zhaoxiaodong95/Lucifer/Random Photos Taken/Picture.png

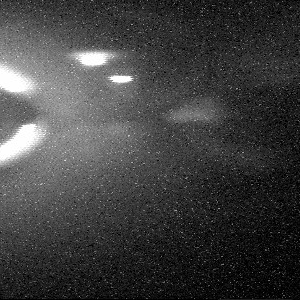
Random Photos Taken/Picture.png
