zhaoxiaodong95/Lucifer/Random Photos Taken/woot.png

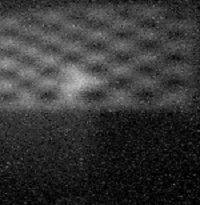
Random Photos Taken/woot.png
