zhaoxiaodong95/Lucifer/Source/Readme.md

Original source code written in Processing for Arduino
