zhaoxiaodong95/Lucifer/Marketing Brochure/Glow/Brochure Back Glow.jpg

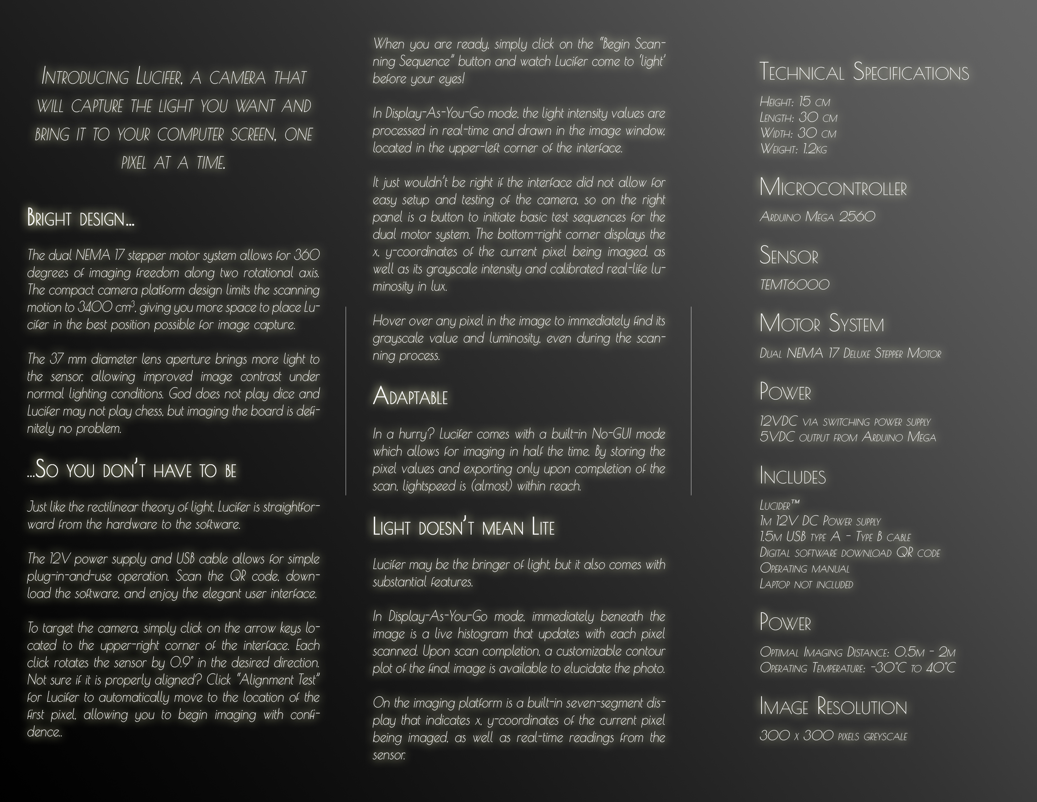
Marketing Brochure/Glow/Brochure Back Glow.jpg
