zhaoxiaodong95/Lucifer/Marketing Brochure/Glow/Brochure Front Glow.jpg

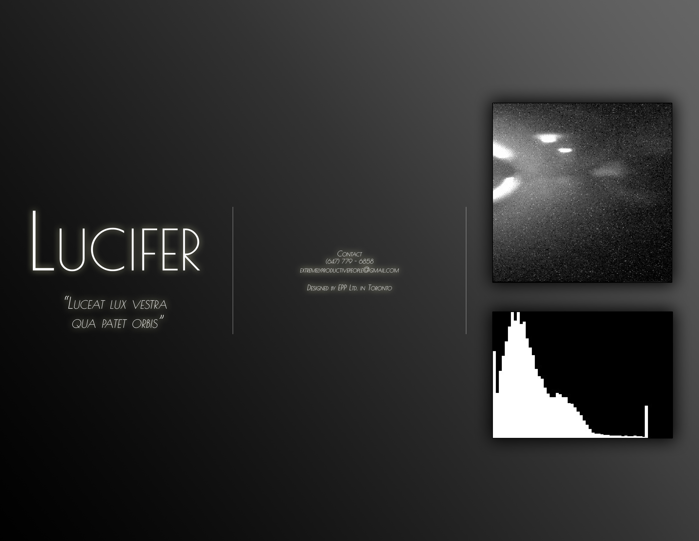
Marketing Brochure/Glow/Brochure Front Glow.jpg
