zhaoxiaodong95/Lucifer/Marketing Brochure/No-Glow/Brochure Back NoGlow.jpg

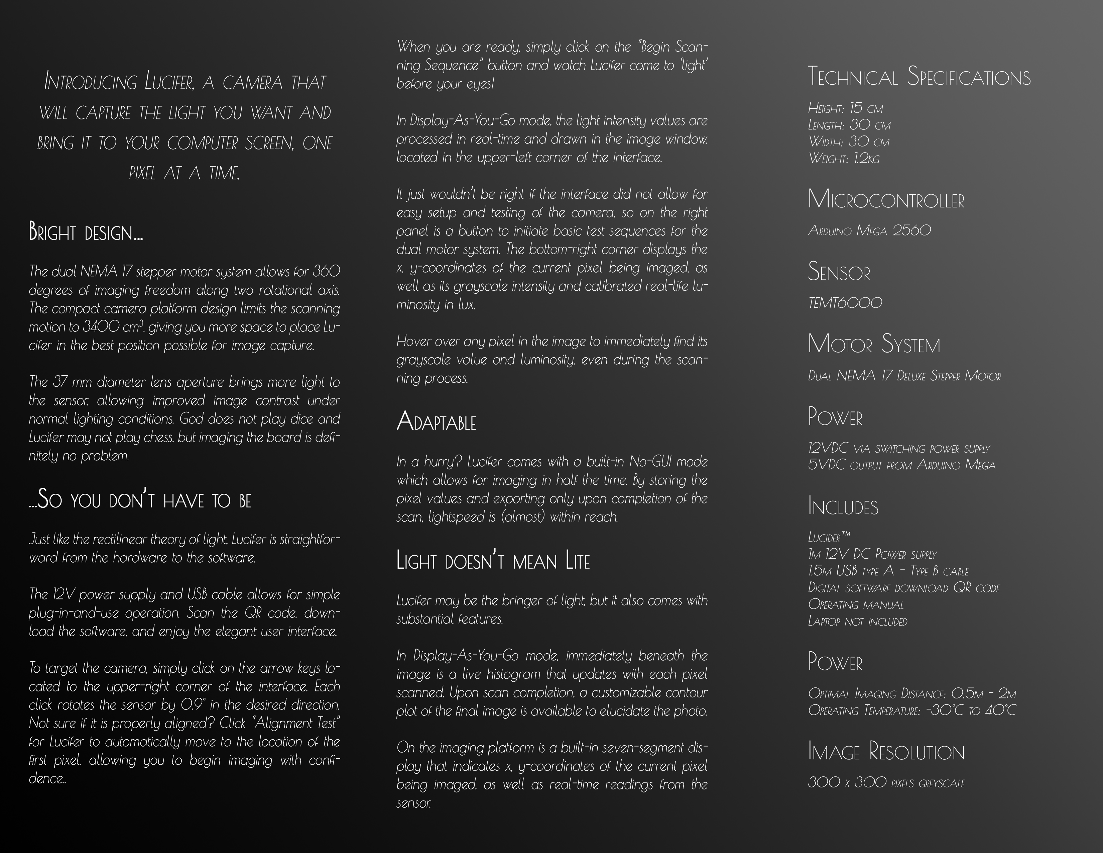
Marketing Brochure/No-Glow/Brochure Back NoGlow.jpg
