zhaoxiaodong95/Lucifer/Random Photos Taken/40x40.PNG

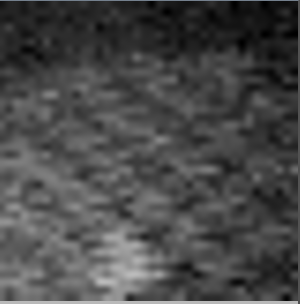
Random Photos Taken/40x40.PNG
