zhaoxiaodong95/Lucifer/Random Photos Taken/chessboard.PNG

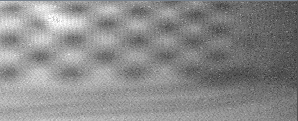
Random Photos Taken/chessboard.PNG
