zhaoxiaodong95/Lucifer/Random Photos Taken/noice we're done.PNG

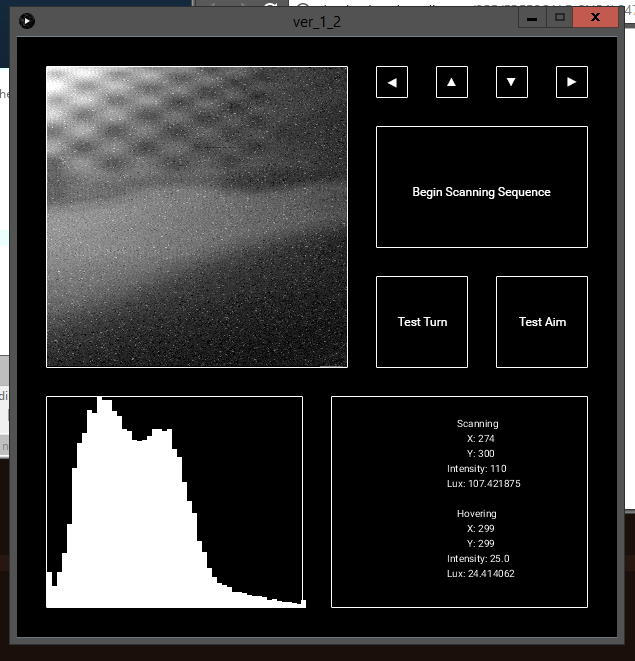
Random Photos Taken/noice we're done.PNG
