zhaoxiaodong95/Lucifer/Random Photos Taken/we done bois.jpg

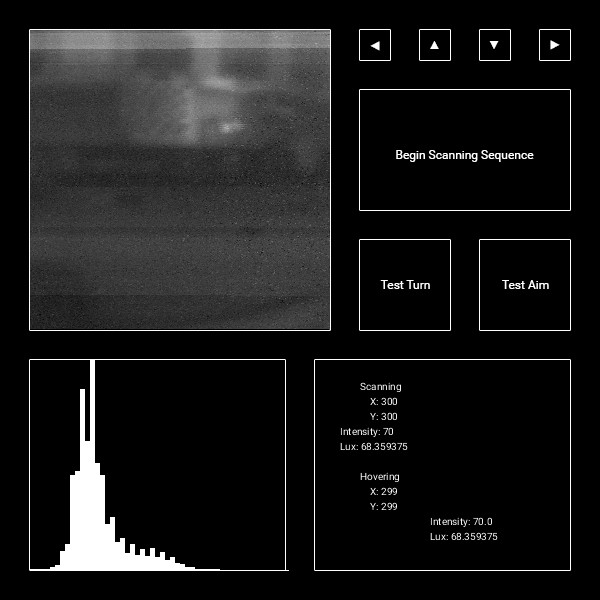
Random Photos Taken/we done bois.jpg
