zhaoxiaodong95/Lucifer/Source/bg.jpg

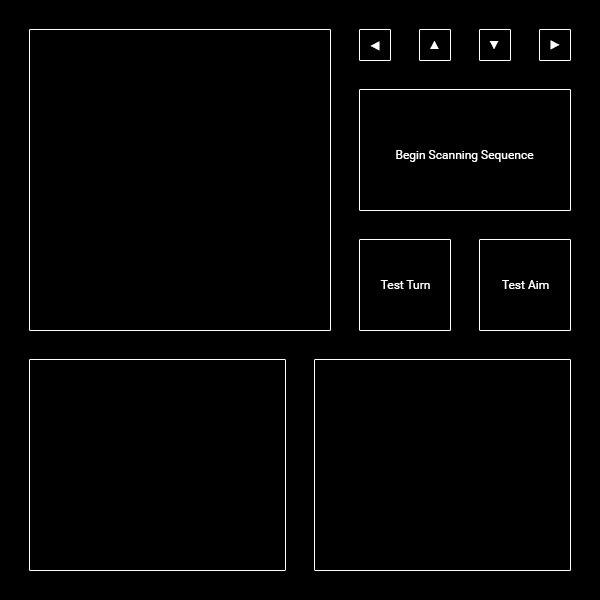
Source/bg.jpg
