zhaoxiaodong95/Lucifer/Design Blueprints/Base.pdf

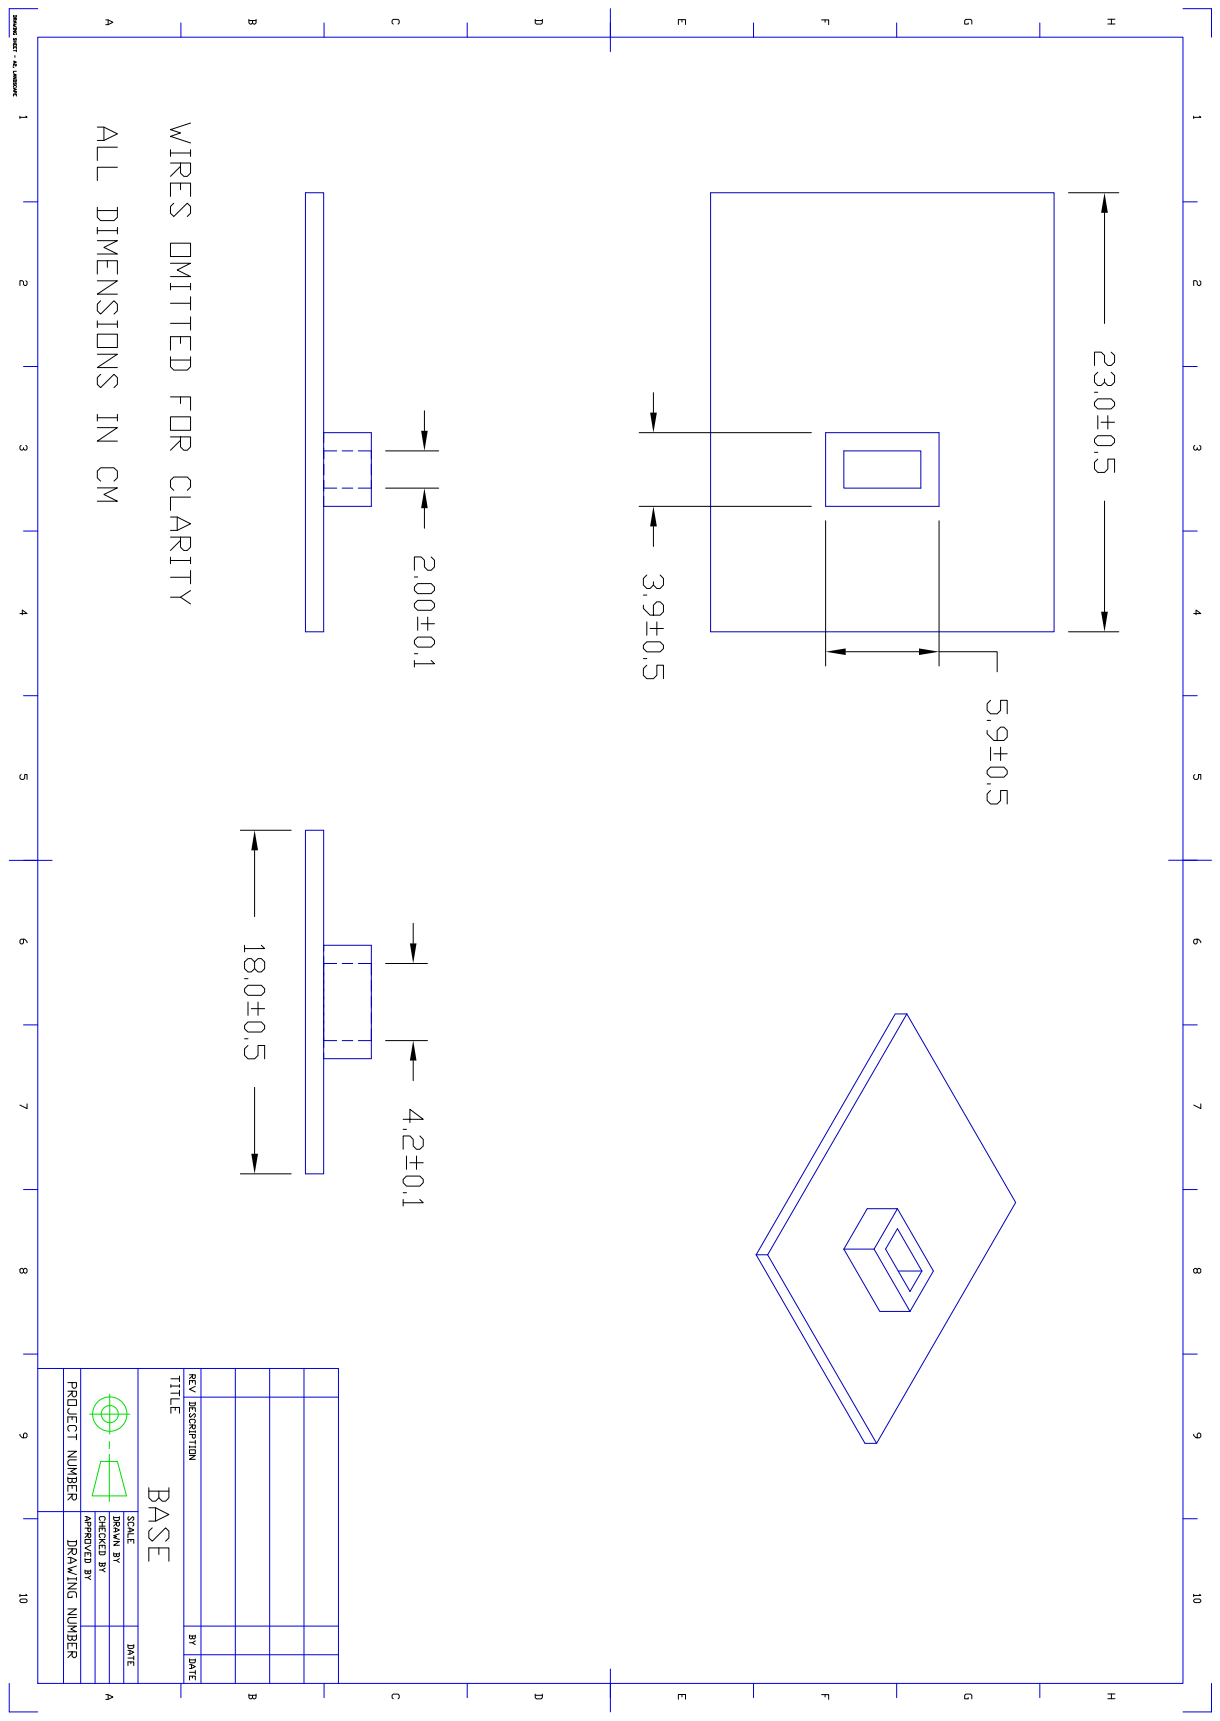
[picture p22: page 1]
