zhaoxiaodong95/Lucifer/Design Blueprints/Camera Assembly.pdf

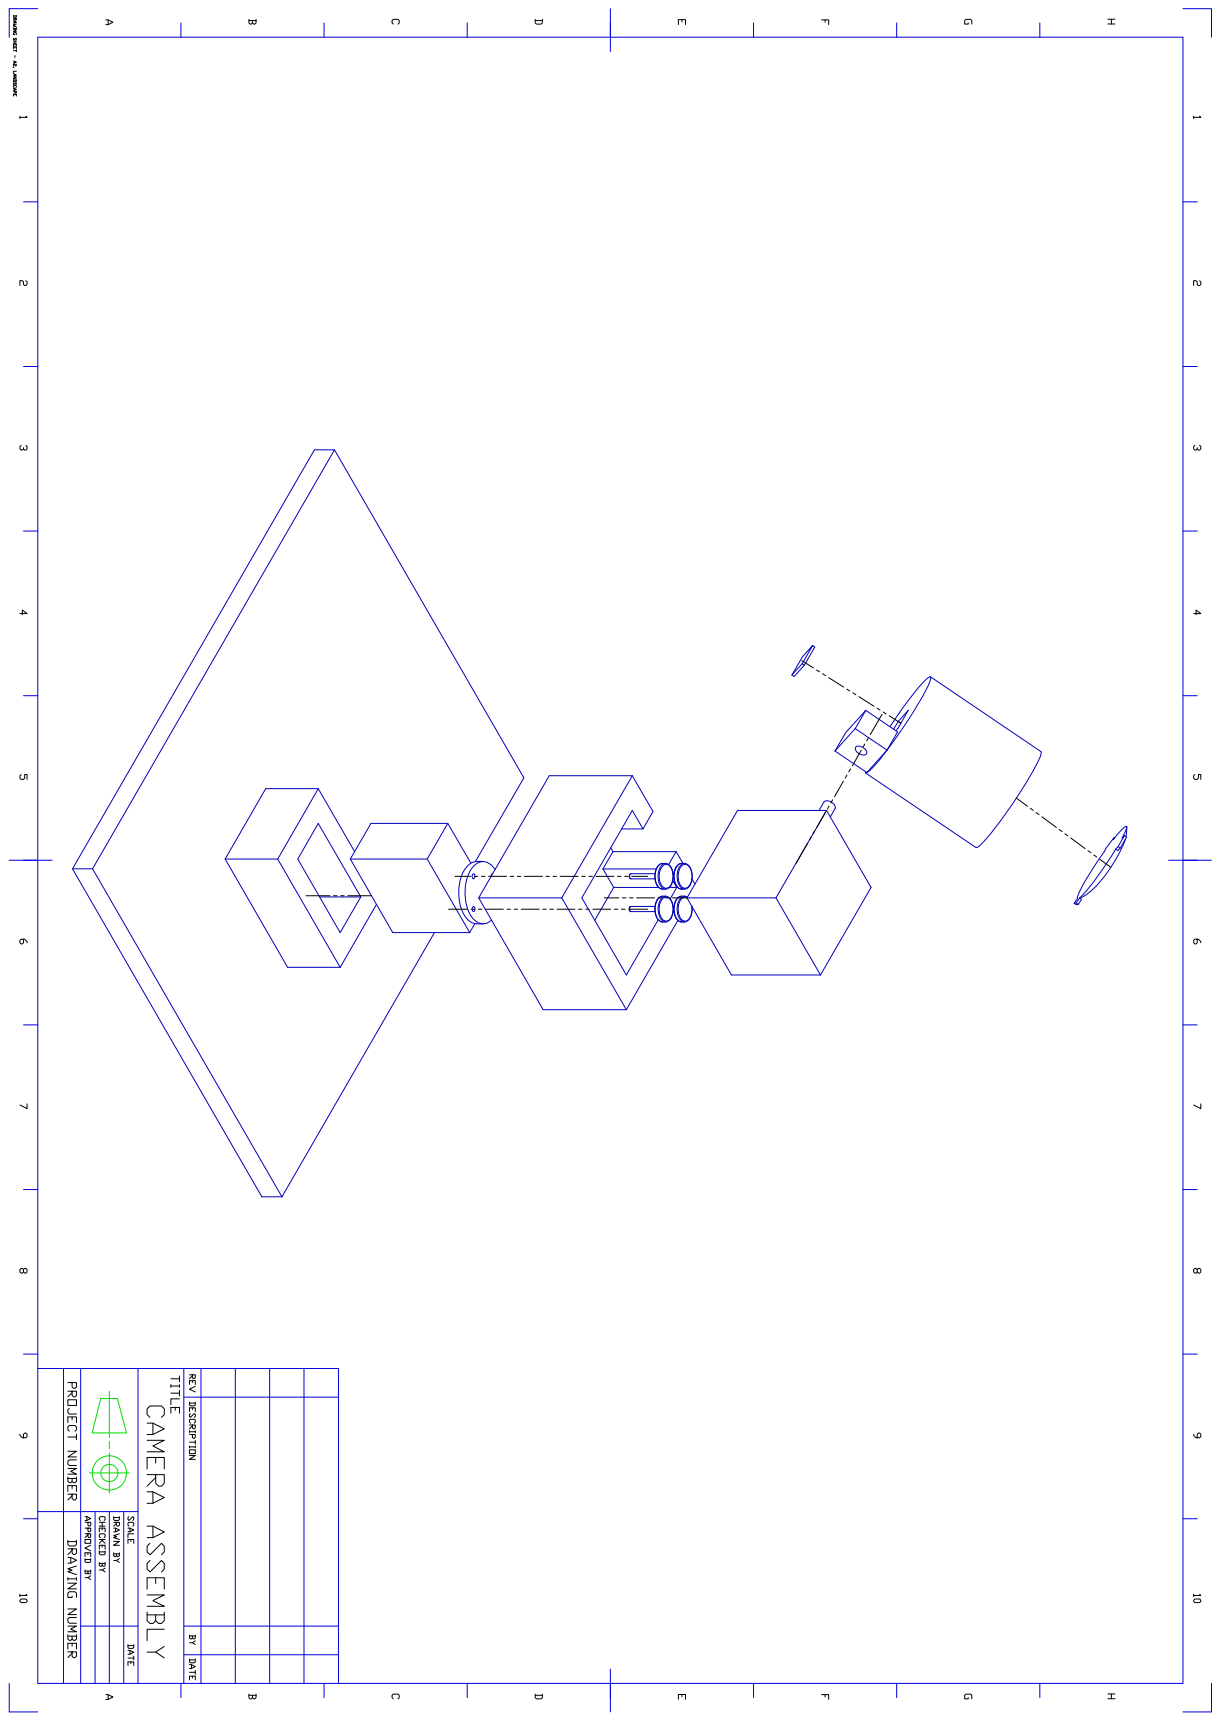
[picture p23: page 1]
