zhaoxiaodong95/Lucifer/Design Blueprints/Imaging Assembly.pdf

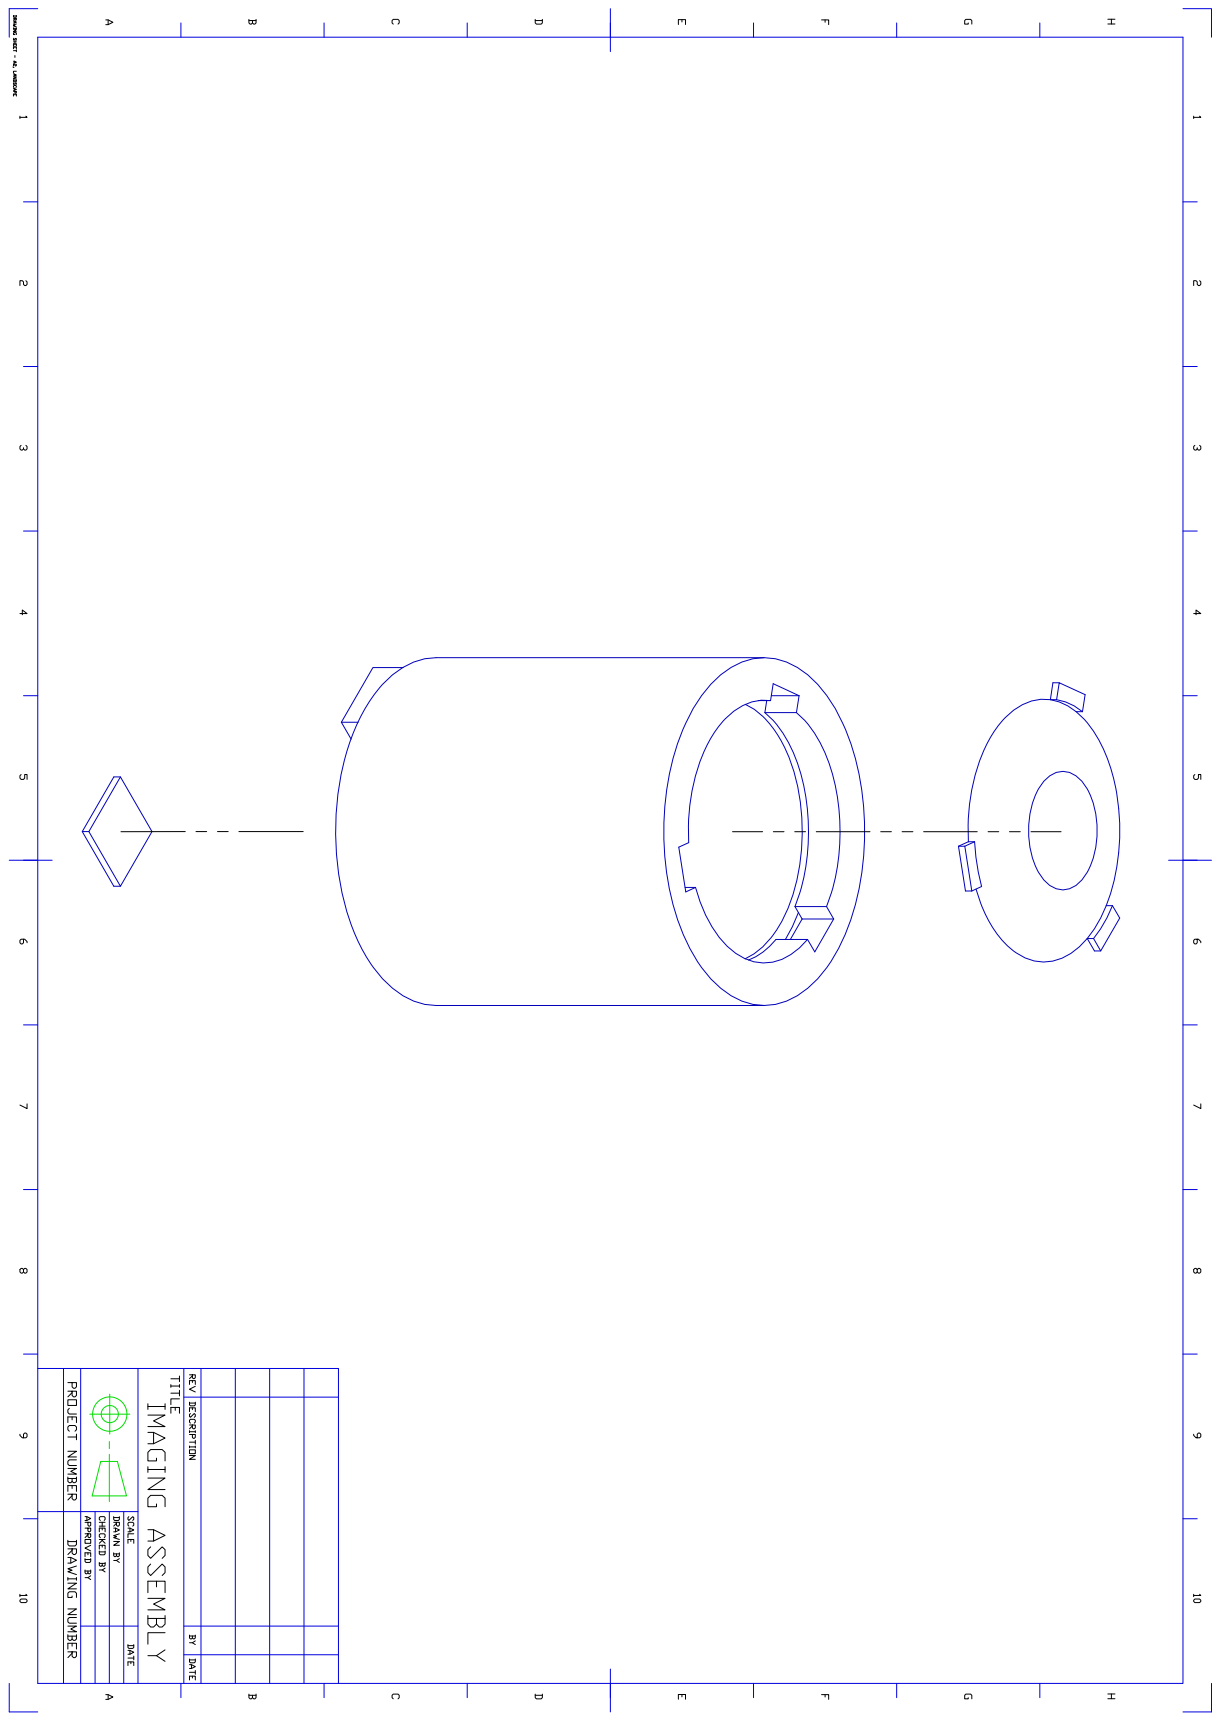
[picture p24: page 1]
