zhaoxiaodong95/Lucifer/Design Blueprints/Lens.pdf

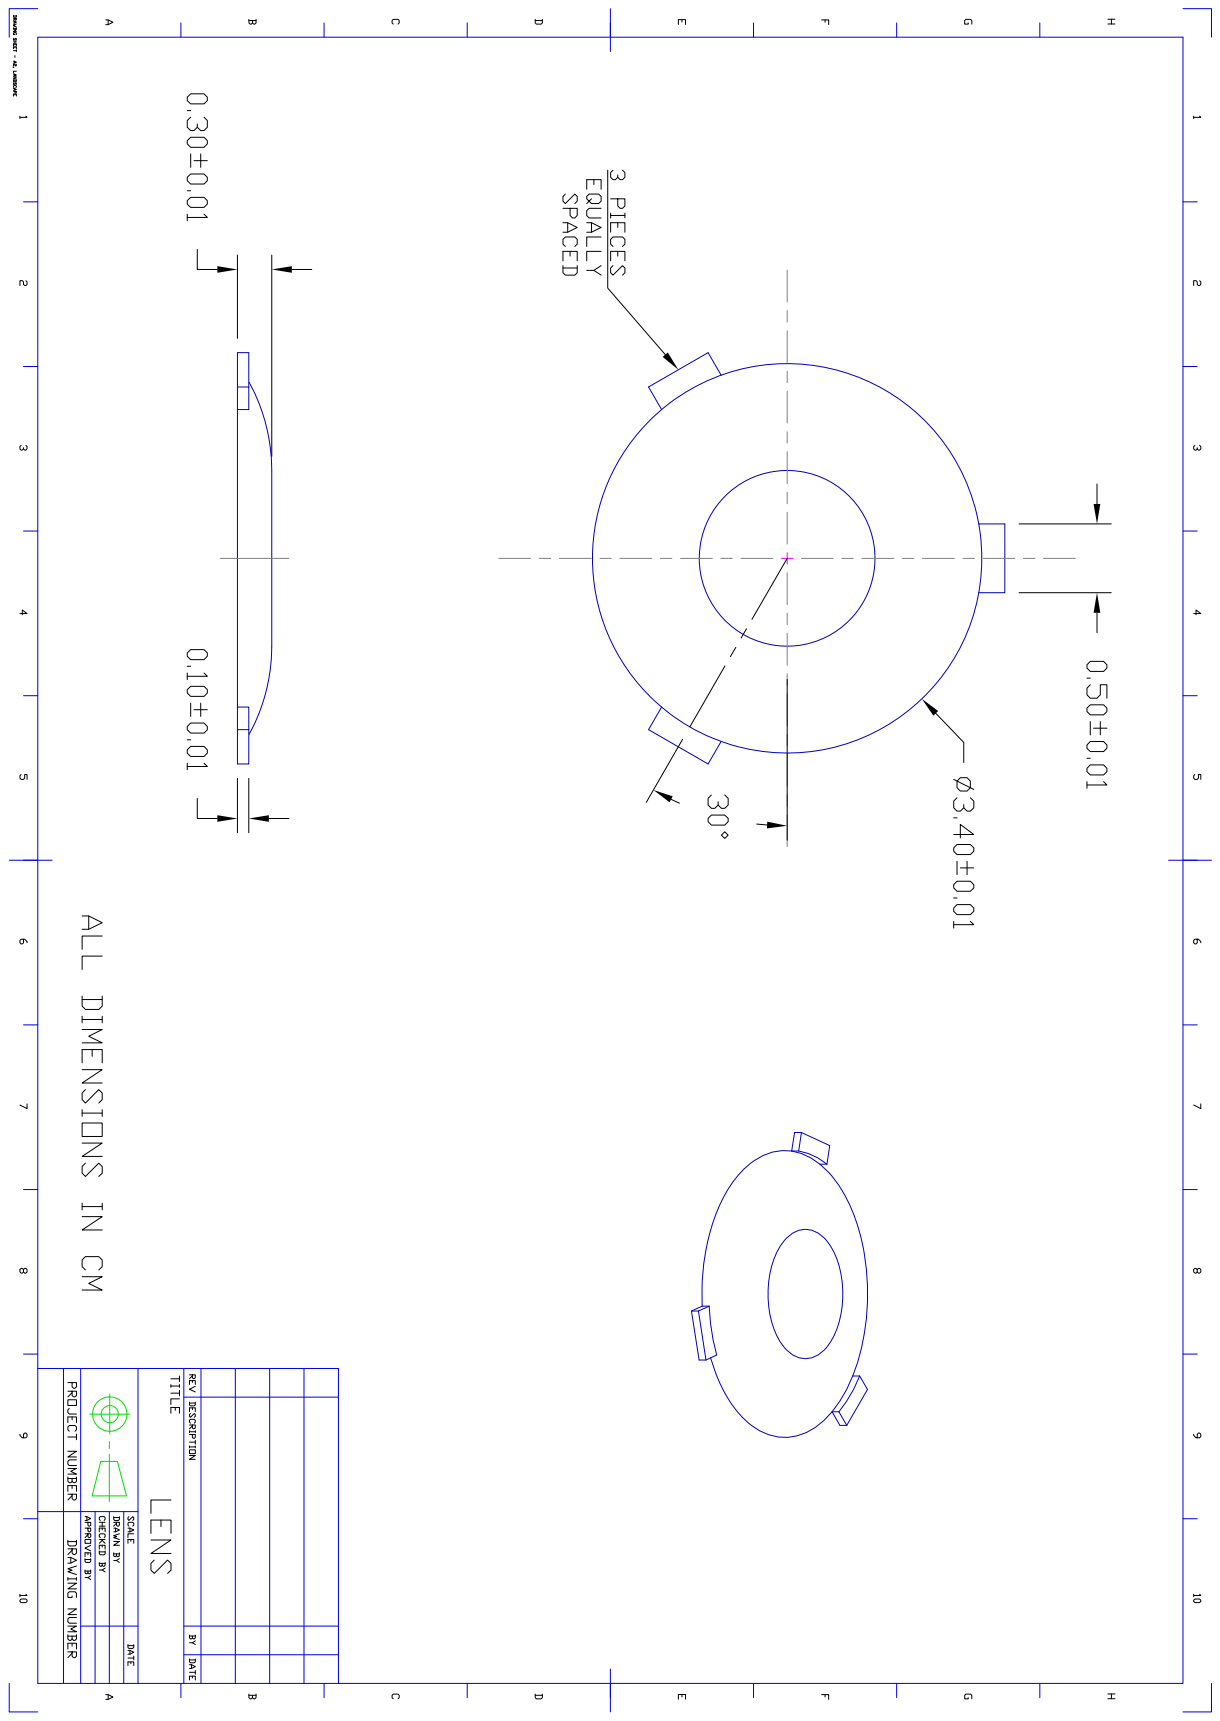
[picture p25: page 1]
