zhaoxiaodong95/Lucifer/Design Blueprints/Sensor Tube.pdf

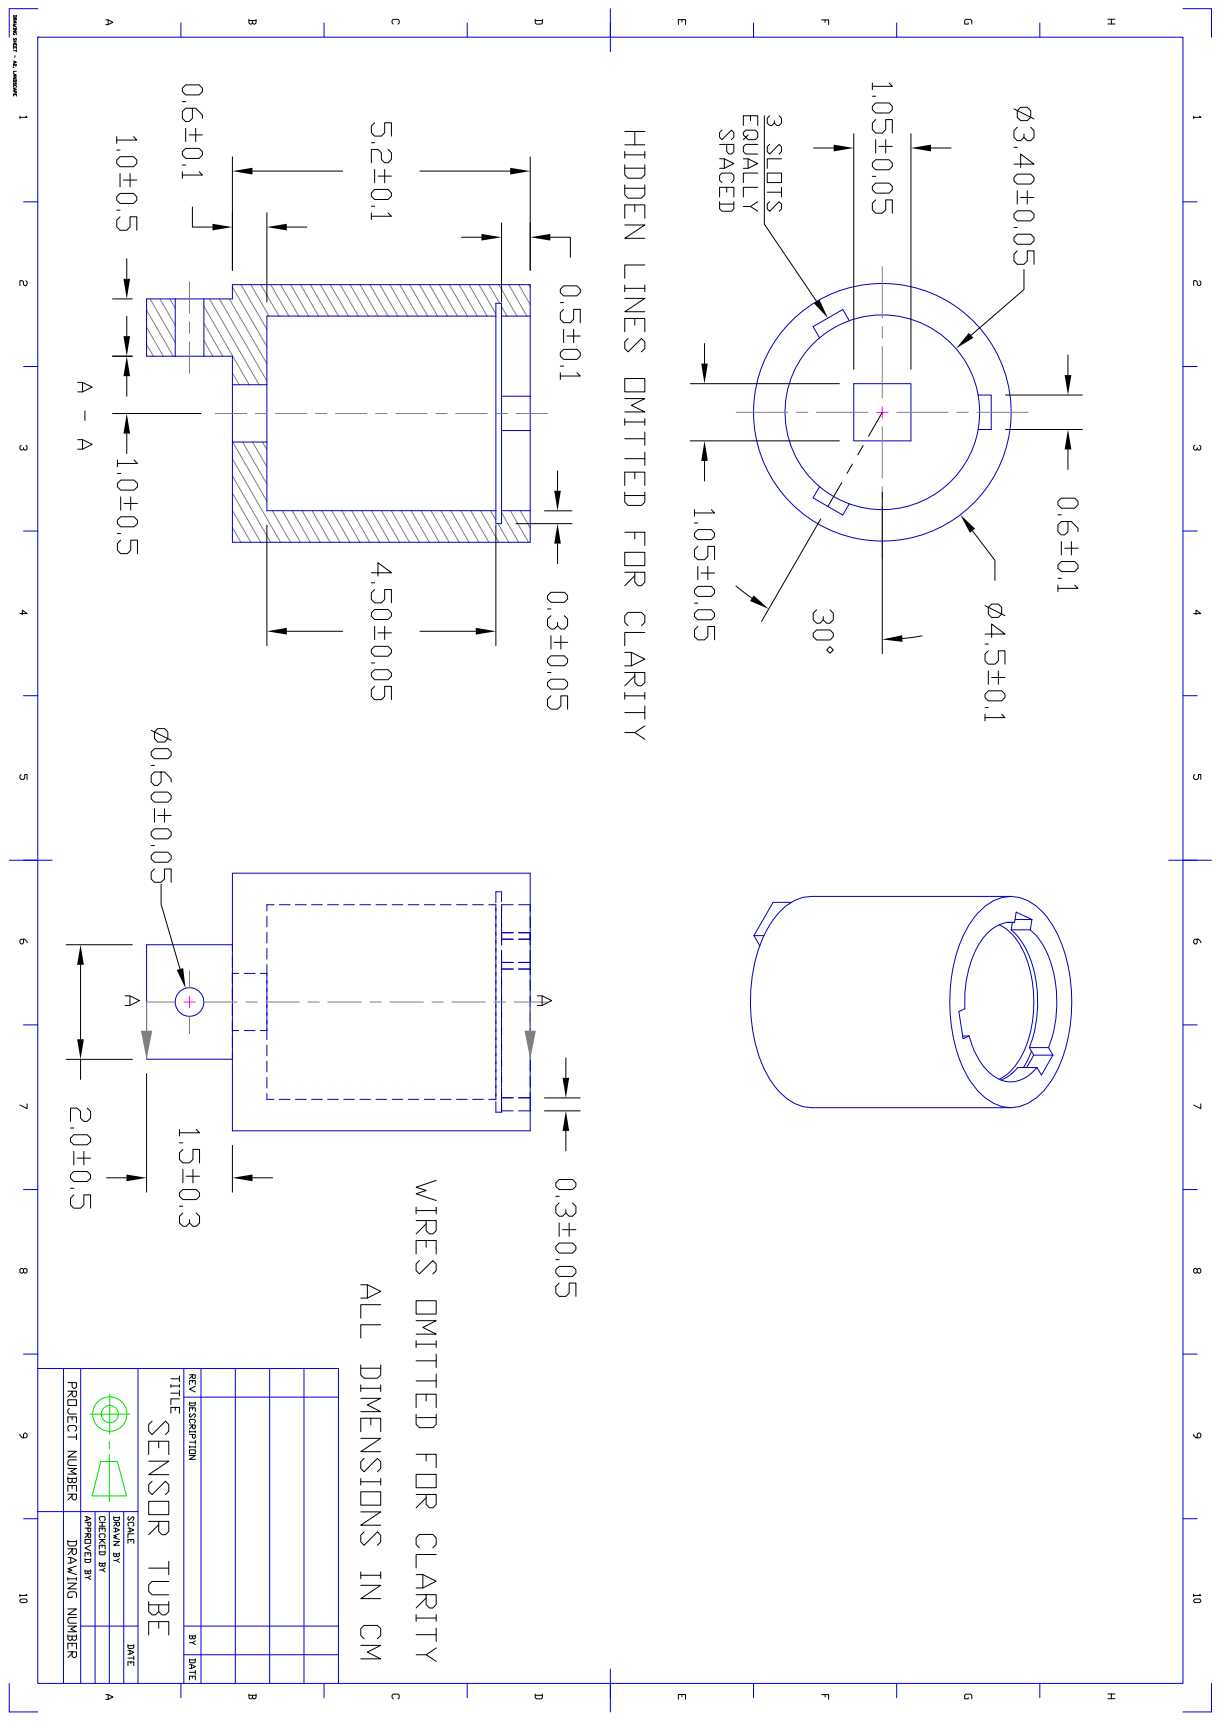
[picture p26: page 1]
