zhaoxiaodong95/Lucifer/Design Blueprints/Servo Motor.pdf

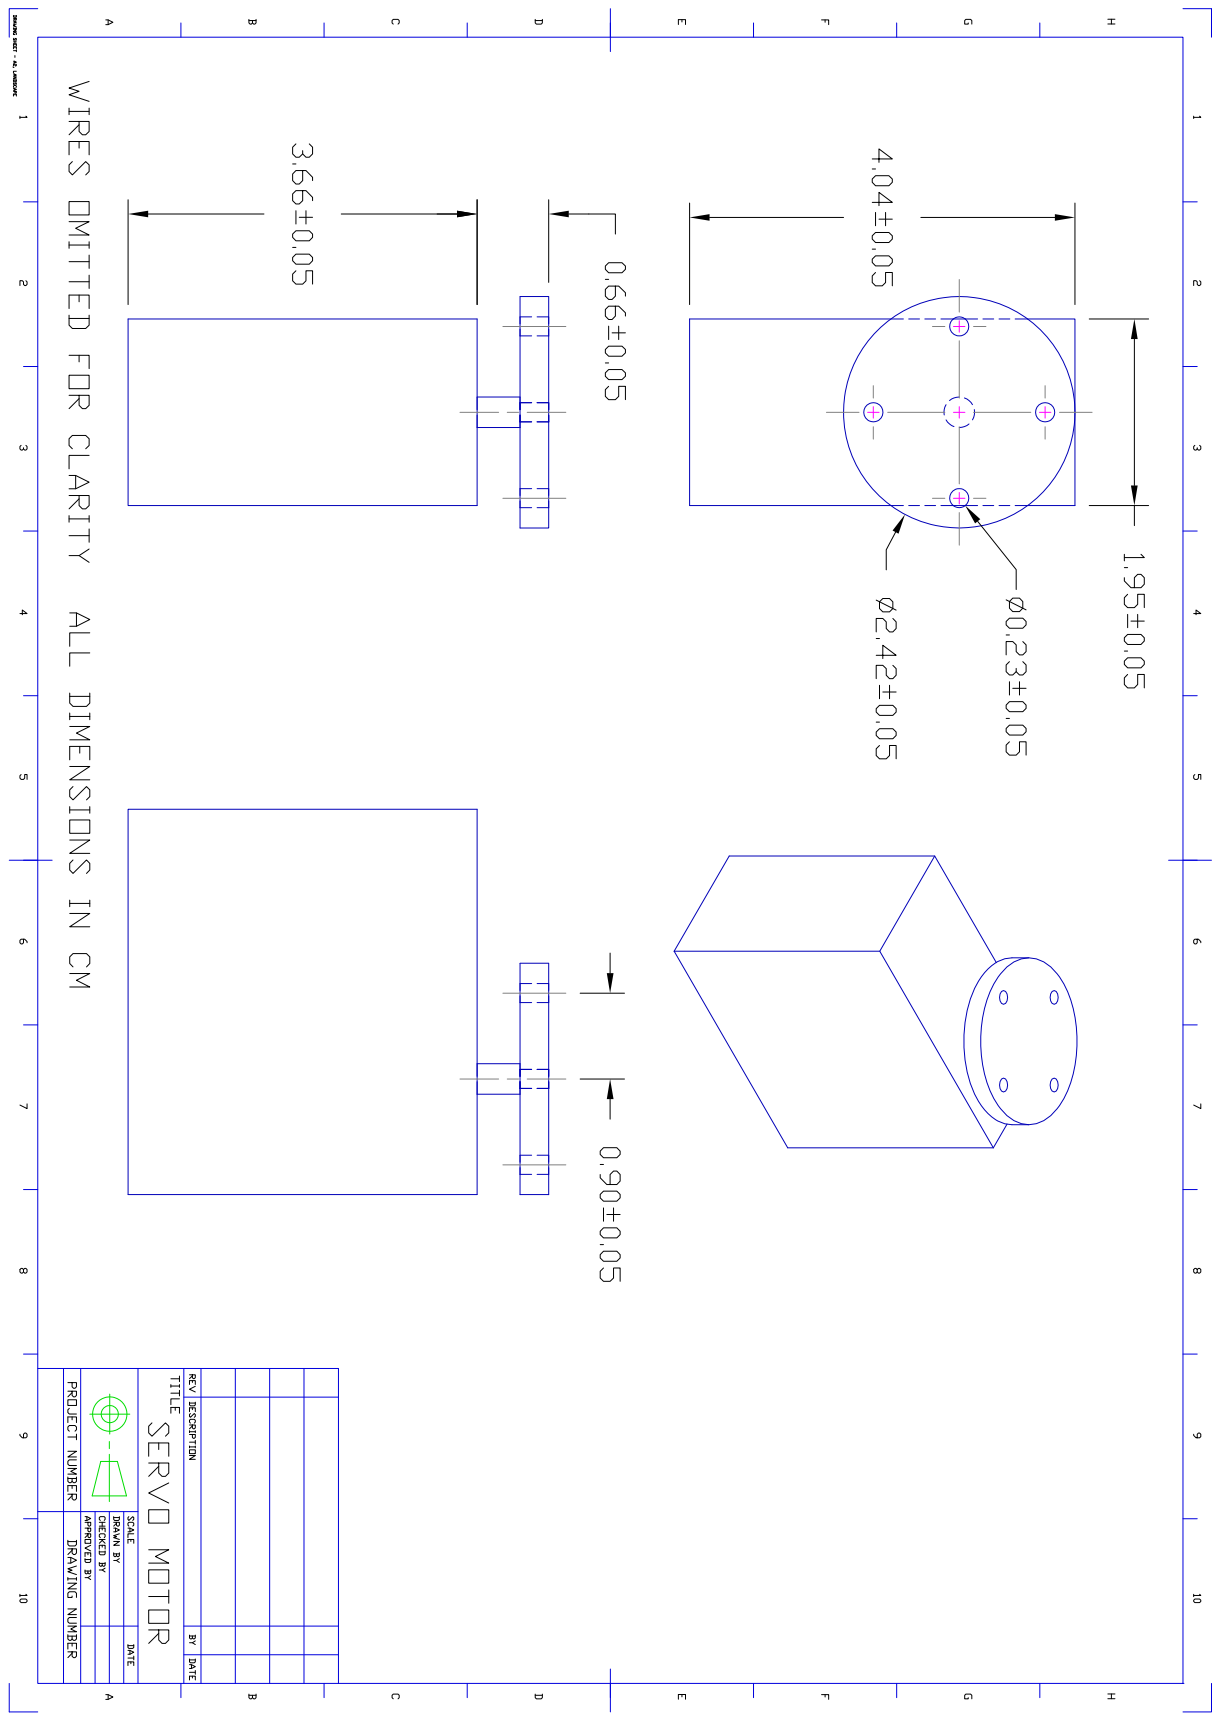
[picture p27: page 1]
