zhaoxiaodong95/Lucifer/Design Blueprints/Stepper Casing Pin.pdf

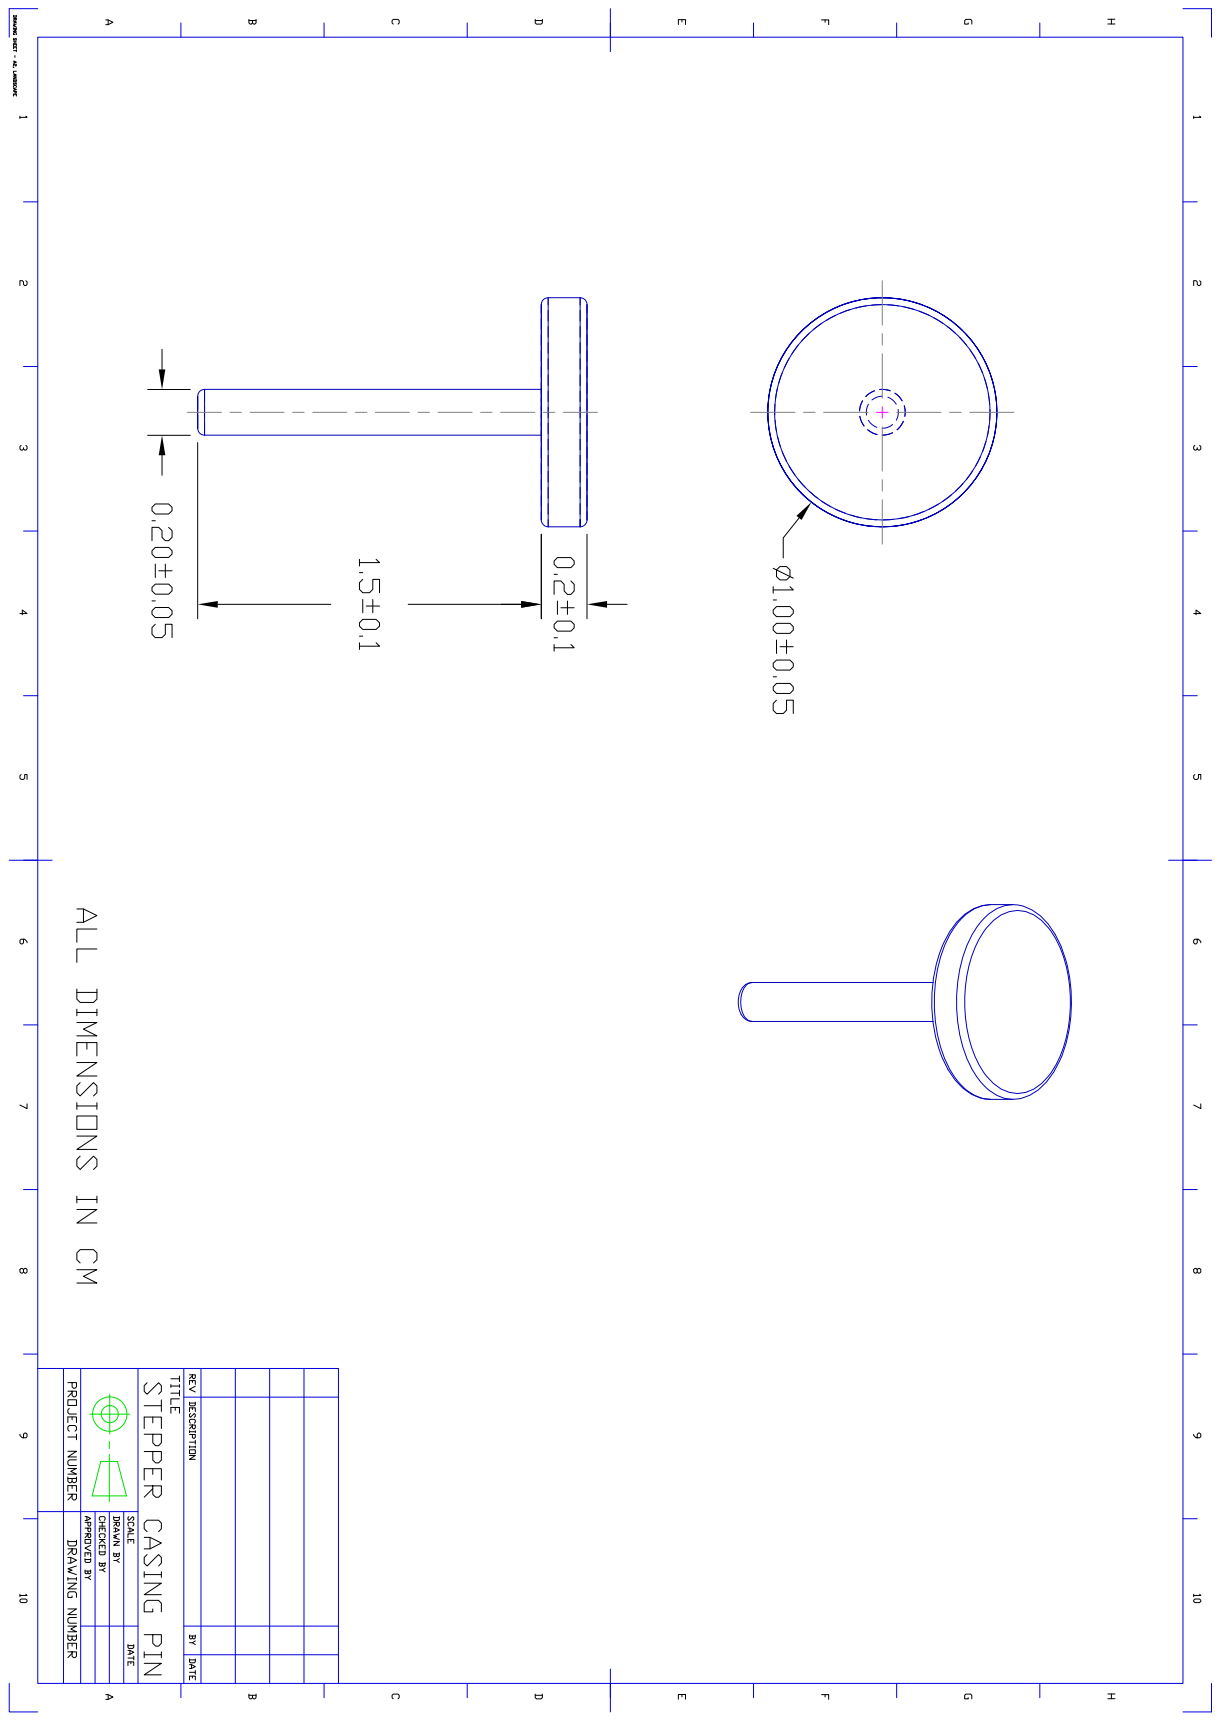
[picture p28: page 1]
