zhaoxiaodong95/Lucifer/Design Blueprints/Stepper Casing.pdf

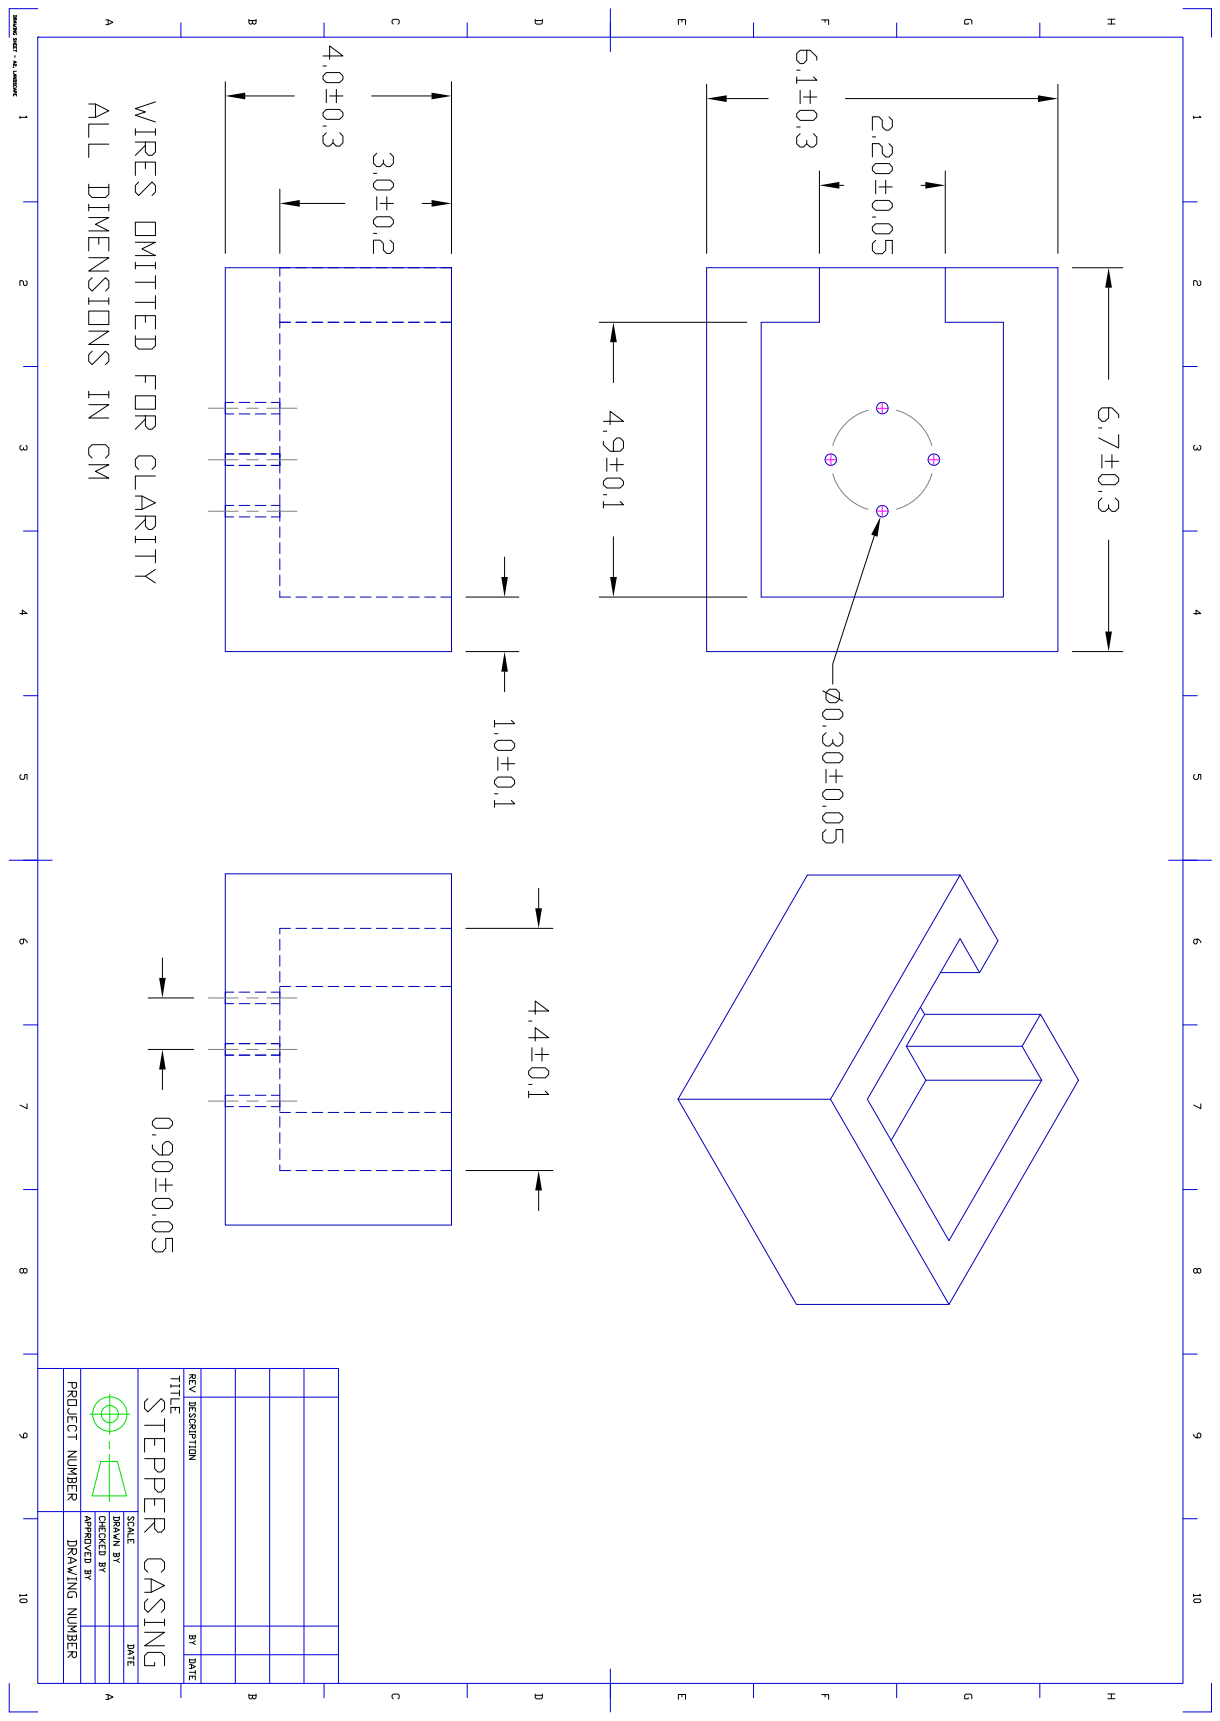
[picture p29: page 1]
