zhaoxiaodong95/Lucifer/Design Blueprints/Stepper Motor.pdf

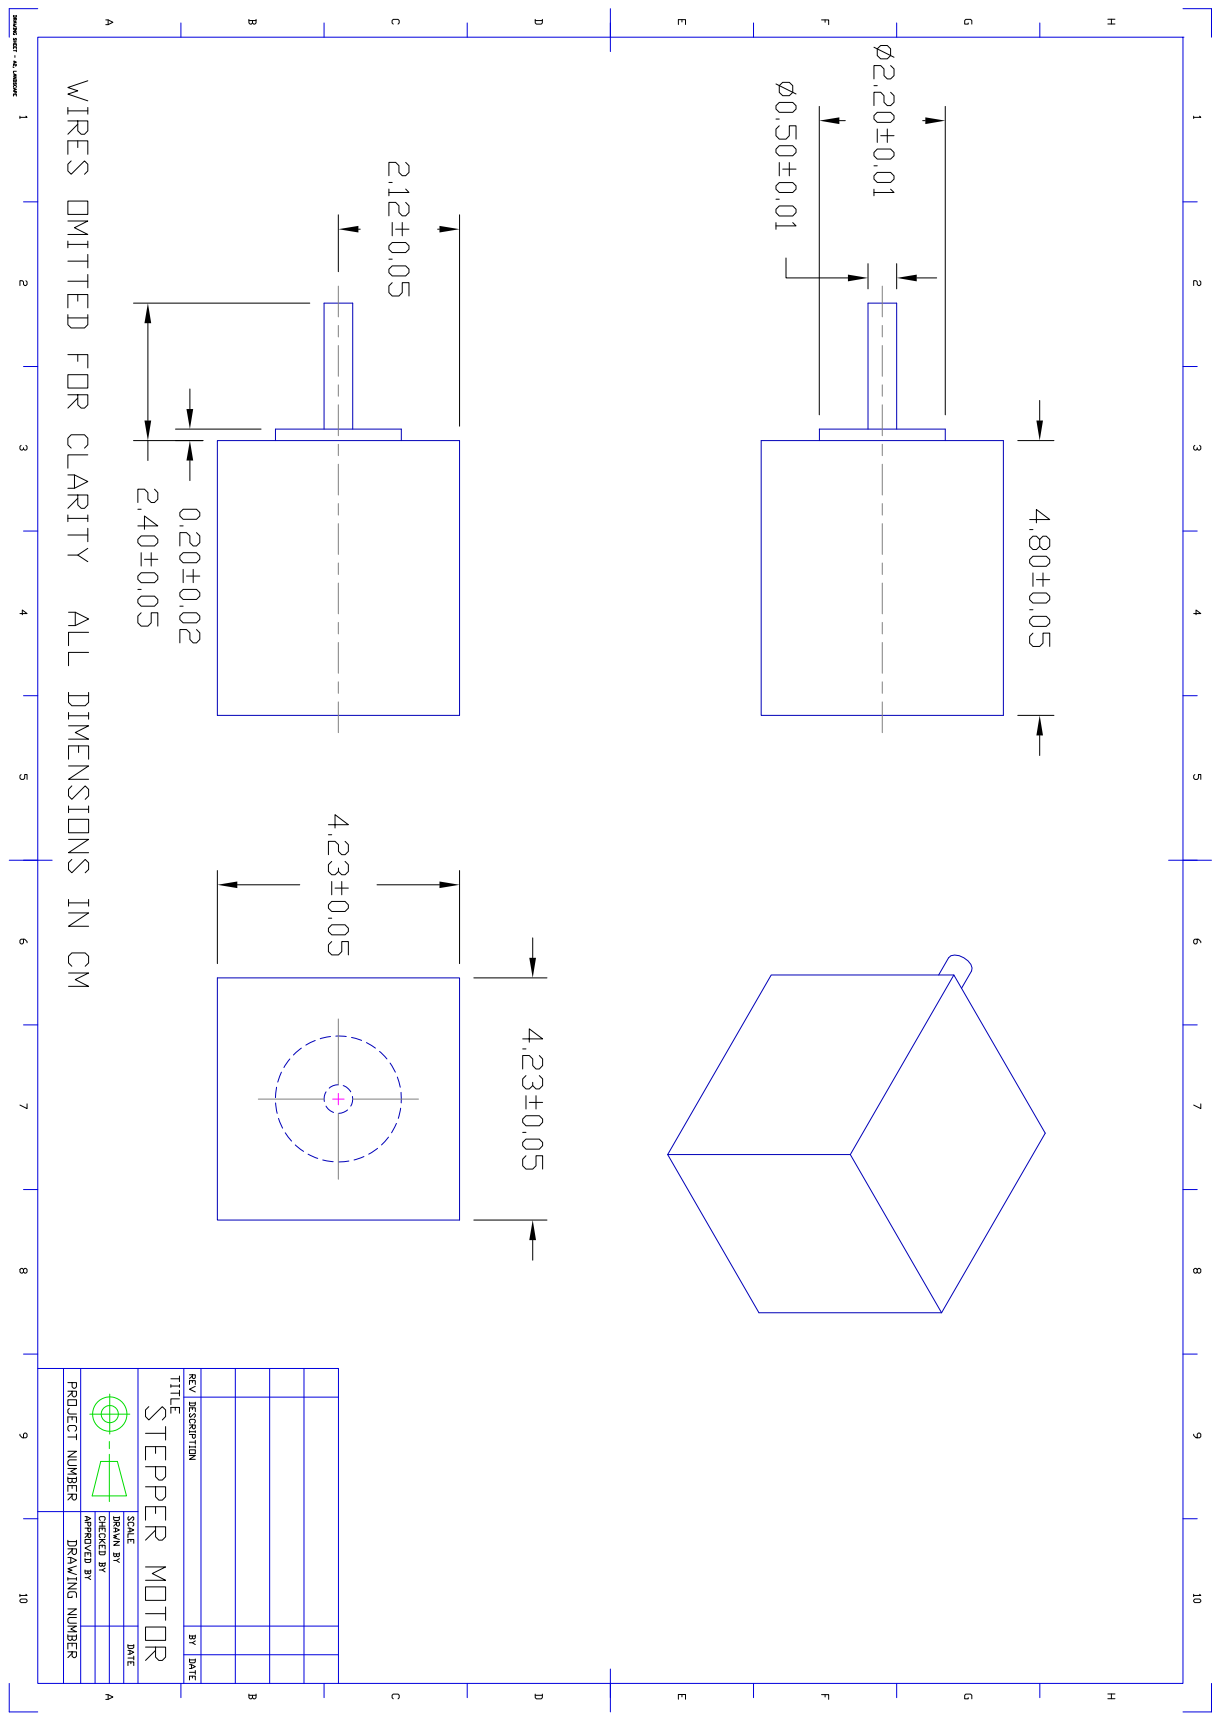
[picture p30: page 1]
