zhaoxiaodong95/Lucifer/Design Blueprints/TEMT6000.pdf

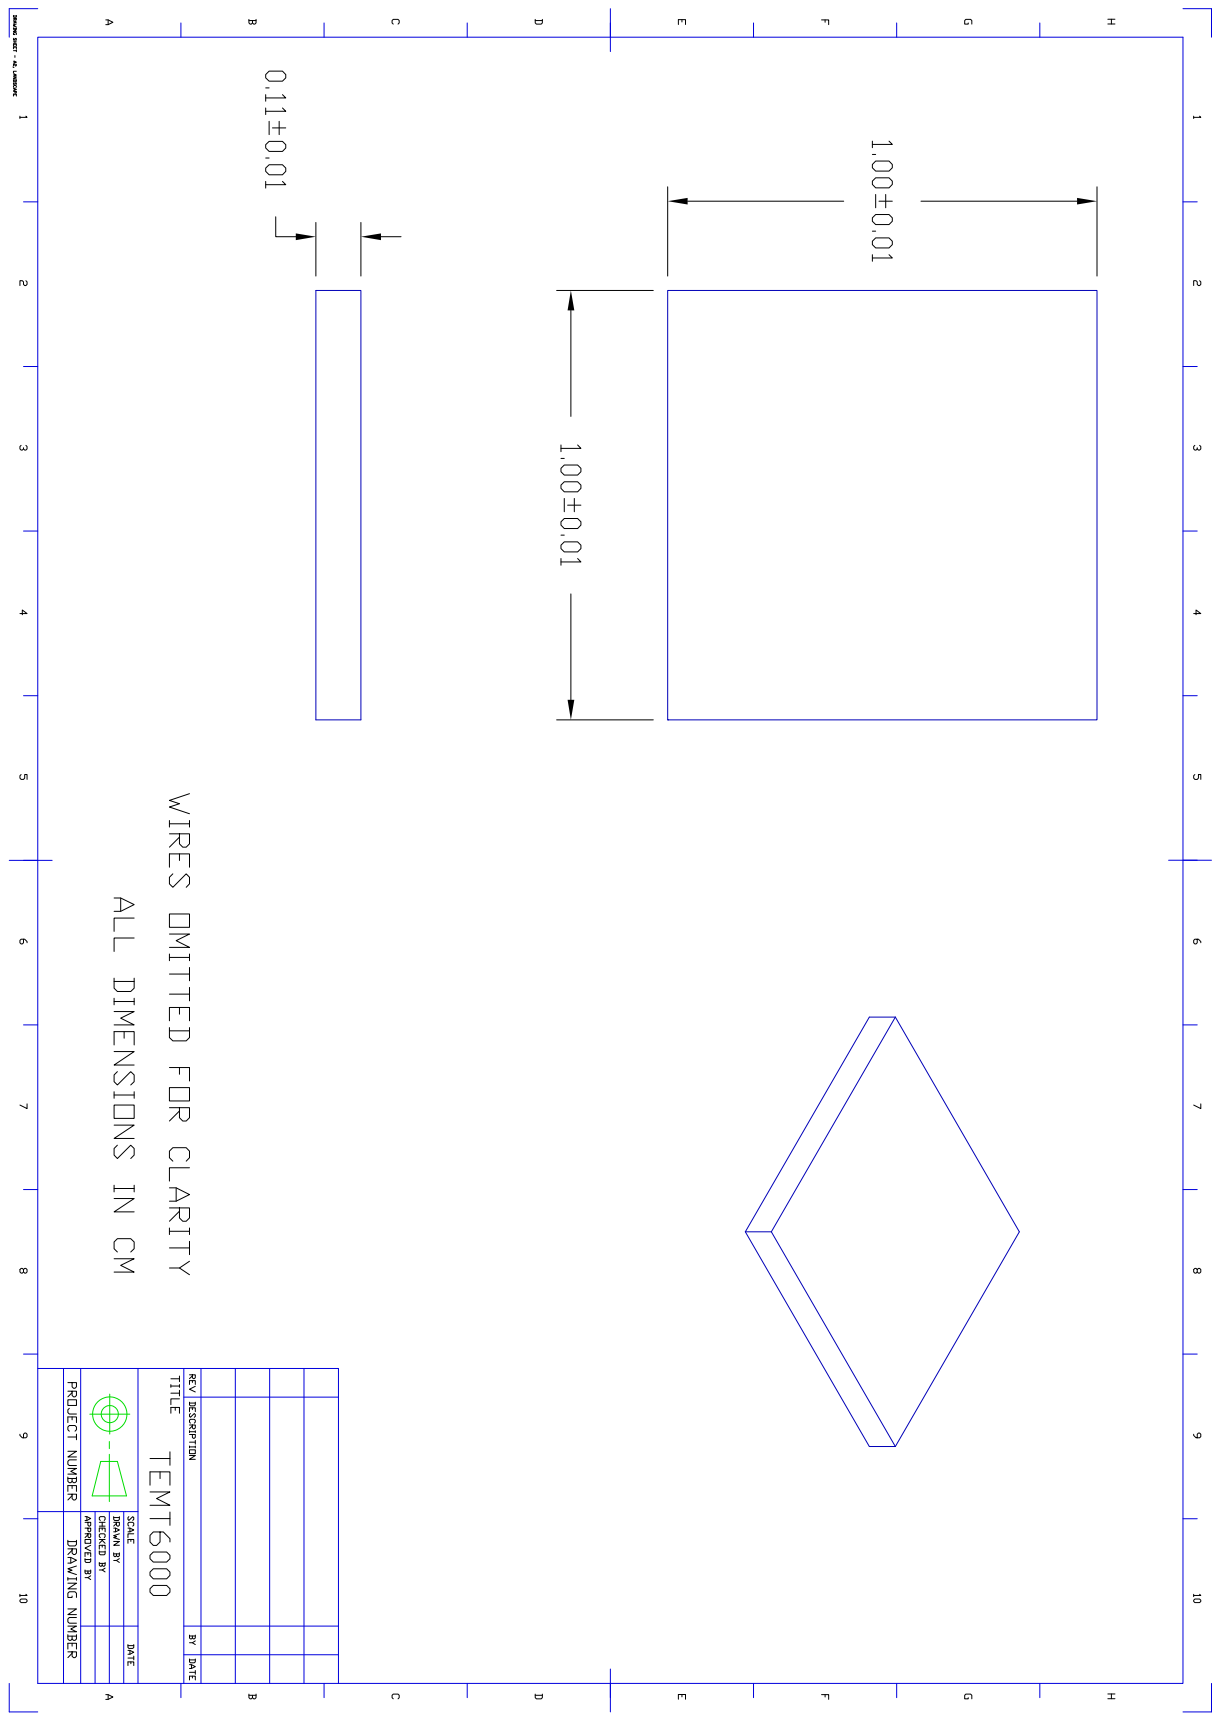
[picture p31: page 1]
